MathFerreiraDev/fonte_tensao_corrente_regulaveis/(commit log)

2026-06-14 Revise README for adjustable power supply project
    Updated the README to provide detailed information about the adjustable power supply project, including objectives, circuit description, component details, and operational modes.
2026-07-04 correcao de formato
2026-07-04 reajuste de medidas
2026-07-05 Revise physical circuit section in README
    Updated the physical circuit section with new images and a video link.
2026-07-07 Programação necessária para o Arduino Nano
2026-07-08 Revise Zener diode and TIP36C sections in README
    Updated sections on Zener diode polarization and TIP36C power dissipation. Added bleeder resistor verification.
2026-07-08 Refine README content for power supply project
    Updated the README to improve clarity and remove redundant information regarding the design and operation of the adjustable linear power supply.
2026-07-08 Update detail about external connections in README
    Clarify the external connections of Arduino and display.
2026-07-08 Refine Zener diode description in README
    Removed unnecessary wording from Zener diode description.
2026-07-11 Simplify warning about worst-case scenario
    Removed unnecessary detail about TIP36C power rating.
